horacekj/mgrthesis/thesis.tex

\documentclass[digital, oneside, table, nolot, nolof]{fithesis3}
%\documentclass[printed, twoside, table, nolot, nolof]{fithesis3}

%% The following section sets up the locales used in the thesis.
\usepackage[resetfonts]{cmap}
\usepackage[T1]{fontenc}
\usepackage[main=czech, english]{babel}

%% The following section sets up the metadata of the thesis.
\thesissetup{
    date          = \the\year/\the\month/\the\day,
    university    = mu,
    faculty       = fi,
    type          = mgr,
    author        = Jan Horáček,
    gender        = m,
    advisor       = {RNDr. Zdeněk Matěj, Ph.D.},
    title         = {Návrh a implementace nového protokolu sběrnice MTBbus},
    TeXtitle      = {Návrh a implementace nového protokolu sběrnice MTBbus},
    keywords      = {sběrnice, plc, mtb, mtbbus, rs485, embedded, stm32, qt, usb, cdc, protokol, avr, arm, dcc},
    TeXkeywords   = {sběrnice, plc, mtb, mtbbus, rs485, embedded, stm32, qt, usb, cdc, protokol, avr, arm, dcc},
    abstract      = {\input{abstrakt.tex}},
    thanks        = {\input{dik.tex}},
    bib           = bibliography.bib,
    titleEn       = {Design and implementation of a new MTBbus protocol},
    TeXtitleEn    = {Design and implementation of a new MTBbus protocol},
    keywordsEn    = {bus, mtb, rs485, embedded, stm32, C++, qt, protocol, avr, arm, kicad},
    TeXkeywordsEn = {bus, mtb, rs485, embedded, stm32, C++, qt, protocol, avr, arm, kicad},
    assignment    = {data/zadani_ofic.pdf},
}
\usepackage{makeidx}      %% The `makeidx` package contains
\makeindex                %% helper commands for index typesetting.
%% These additional packages are used within the document:
\usepackage{paralist} %% Compact list environments
\usepackage{amsmath}  %% Mathematics
\usepackage{amsthm}
\usepackage{amsfonts}
\usepackage{url}      %% Hyperlinks
\usepackage{listings} %% Source code highlighting
\usepackage{enumitem}
\usepackage{afterpage}
\usepackage{glossaries}
\usepackage{subfigure}
\makeglossaries
\lstset{
  basicstyle      = \ttfamily,%
  identifierstyle = \color{black},%
  keywordstyle    = \color{blue},%
  keywordstyle    = {[2]\color{cyan}},%
  keywordstyle    = {[3]\color{olive}},%
  stringstyle     = \color{teal},%
  commentstyle    = \itshape\color{magenta}}
\usepackage{floatrow} %% Putting captions above tables
\floatsetup[table]{capposition=top}
\Urlmuskip=0mu plus 1mu
\begin{document}

% Highlight overfulls
% \setlength{\overfullrule}{5pt} % TODO: remove

\setlength{\parindent}{0cm}
\setlength{\parskip}{3mm plus2pt minus2pt}
\setlist{leftmargin=8mm}
\renewenvironment{compactenum}
	{\begin{enumerate}[leftmargin=8mm,itemsep=0pt,parsep=1pt,topsep=1pt,partopsep=1pt]}
	{\end{enumerate}}
\renewenvironment{compactitem}
	{\begin{itemize}[leftmargin=8mm,itemsep=0pt,parsep=0pt,topsep=1pt,partopsep=1pt]}
	{\end{itemize}}

\input{zkratky}

\chapter{Úvod} \label{chap:uvod}
\input{uvod}

\chapter{Současné nasazení sběrnice MTBbus} \label{chap:nasazeni}
\input{soucasne-nasazeni}

\chapter{Existující řešení} \label{chap:existujici-reseni}
\input{existujici-reseni}

\chapter{Návrh MTB v4} \label{chap:mtb-v4-design}
\input{mtbv4-design}

\chapter{Implementace MTB v4} \label{chap:mtb-v4-impl}
\input{mtb-usb-v4}
\input{mtb-uni-v4}
\input{mtb-2-avr}
\input{irdet}
\input{mtb-daemon}
\input{mtb-net-lib}

\chapter{Závěr} \label{chap:zaver}
\input{zaver}

\printbibliography[heading=bibintoc]

\appendix
\chapter{Přílohy} \label{chap:appendix}
\input{appendix}

\end{document}
