horacekj/mgrthesis/zkratky.tex

\newglossaryentry{plc} {
	name=PLC,
	description={Programmable Logic Controller, robustní zařízení průmyslové
	automatizace}
}

\newglossaryentry{mtb} {
	name=MTB,
	description={Hardwarový systém pro řízení modelových kolejišť složený ze
	sběrnice MTBbus, MTB modulů, MTB-USB desky a~počítačových knihoven}
}

\newglossaryentry{mtbbus} {
	name=MTBbus,
	description={Model Train Bus\footnote{Expanze zkratky do jejího plného
	významu nedává smysl, i tak budeme používat označení MTBbus, protože tak je
	zkratka zaužívaná.}, sběrnice určená pro řízení modelových kolejišť}
}

\newglossaryentry{dcc} {
	name=DCC,
	description={Digital Command Control, mezinárodně užívaný standardizovaný
	systém pro digitální řízení modelové železnice}
}

\newglossaryentry{kmz}{
	name={KMŽ Brno~I},
	description={Klub modelářů železnic Brno~I}
}

\newglossaryentry{nmra}{
	name={NMRA},
	description={National Model Railroad Association}
}

\newglossaryentry{mtbusb}{
	name={MTB-USB},
	description={Master modul sběrnice MTBbus, implementuje rozhraní mezi MTBbus
	a počítačem (USB)}
}

\newglossaryentry{mtbuni}{
	name={MTB-UNI},
	description={Nejrozšířenější slave modul sběrnice MTBbus, má 16~digitálních
	vstupů a~16~digitálních výstupů}
}

\newglossaryentry{ttl}{
	name={TTL},
	description={Transistor-transistor-logic, v~kontextu této práce standard
		definující jaká napěťová úroveň odpovídá jaké logické úrovni}
}

\newglossaryentry{usb}{
	name={USB},
	description={Universal Serial Bus, v současnosti nejpoužívanější sběrnice
	pro připojení periferií k počítači}
}

\newglossaryentry{cdc}{
	name={CDC},
	description={USB Comunications Device Class, třída USB protokolu implementující
		tunelování sériové linky skrze USB}
}

\newglossaryentry{dps}{
	name={DPS},
	description={Deska plošnýcn spojů}
}

\newglossaryentry{scom}{
	name={S-COM},
	description={Jednoduchý jednosměrný komunikační protokol, který umožňuje
	přenášet návěsti návěstidel \cite{scom-specs}}
}

\newglossaryentry{bidib}{
	name={BiDiB},
	description={BiDirectional Bus, viz \url{http://bidib.org/}}
}

\newglossaryentry{hid}{
	name={HID},
	description={Human Interface Device, třída USB protokolu sloužící
	k~připojení zařízení interagujících s~uživatelem – myší, klávesnic apod}
}

\newglossaryentry{dil}{
	name={DIL},
	description={Dual in-line package, způsob provedení pouzdra integrovaných obvodů
		s~dvěma řadami pinů pro osazovaní do děr (tzv. \textit{THT} osazování)}
}

\newglossaryentry{smd}{
	name={SMD},
	description={Surface mount device, elektronická součástka určená pro osazení
		přímo na povrch plošného spoje}
}

\newglossaryentry{led}{
	name={LED},
	description={Light emitting diode, součástka vydávající světlo určité barvy}
}

\newglossaryentry{tcp}{
	name={TCP},
	description={Transmission Control Protocol, používaný protokol transportní
		vrstvy počítačových sítí garantující spolehlivé doručování dat}
}

\newglossaryentry{api}{
	name={API},
	description={Application Interface, rozhraní aplikace}
}

\newglossaryentry{ir}{
	name={IR},
	description={Infra-red}
}

\printglossary[title=Seznam použitých zkratek]
