horacekj/mgrthesis/pres/data/mtb-topology-en.pdf

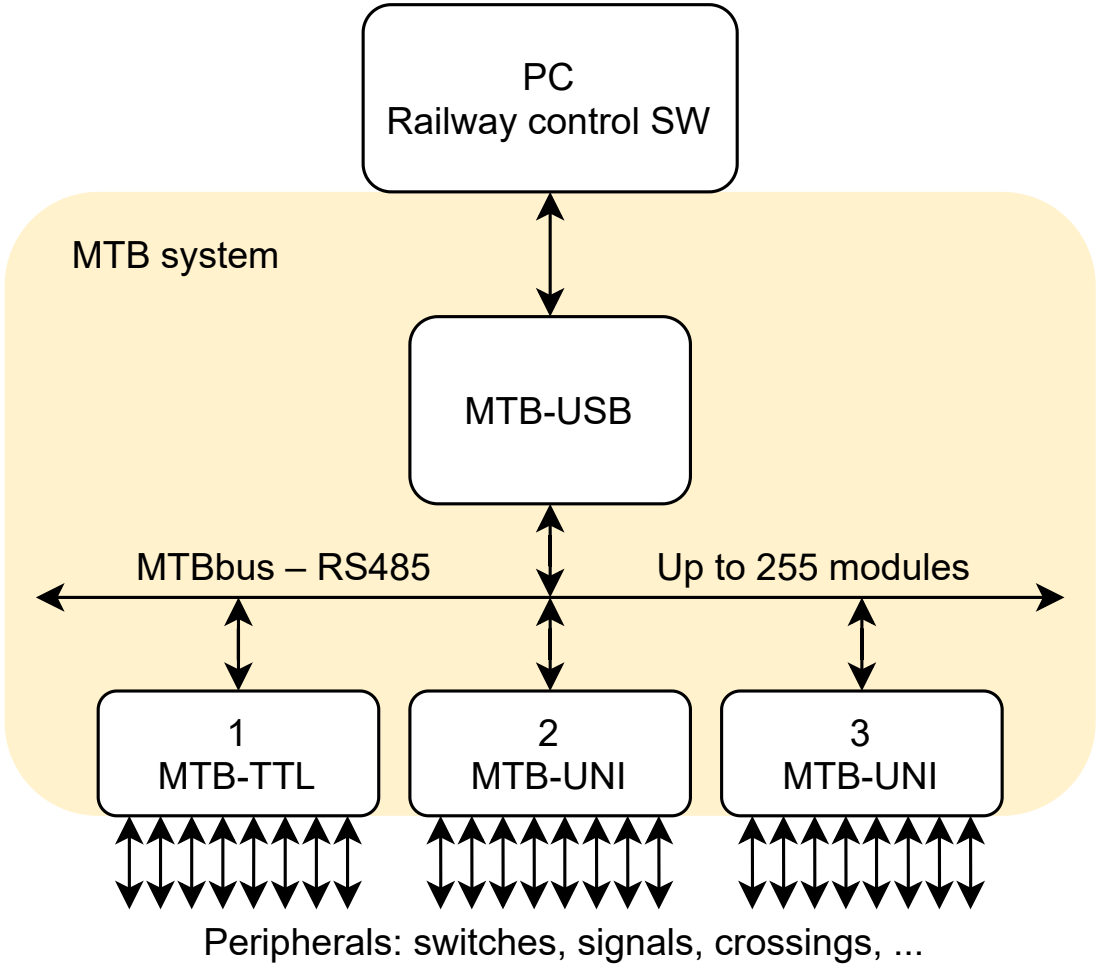
[picture p11: page 1]
MTB-USB; 2 MTB-UNI; 3 MTB-UNI; 1 MTB-TTL; MTBbus – RS485; MTB system

Railway control SW

Up to 255 modules

Peripherals: switches, signals, crossings, ...
