horacekj/mgrthesis/pres/data/new-topology-en.pdf

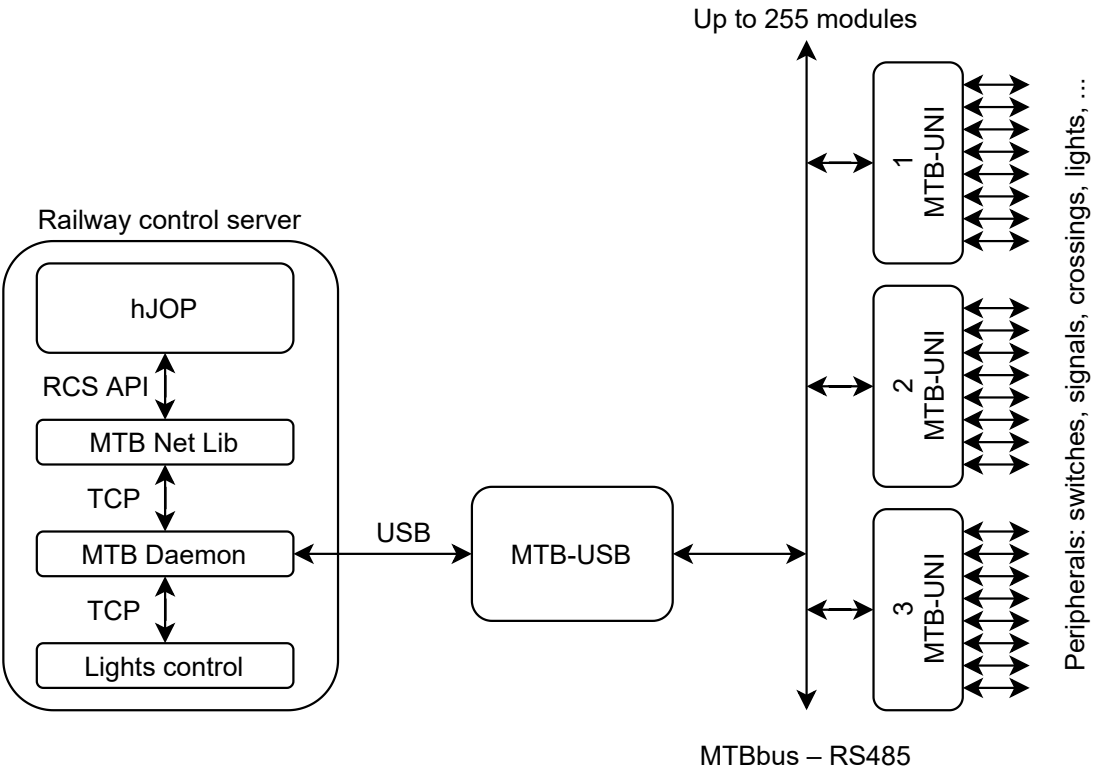
[picture p12: page 1]
MTB-USB; MTBbus – RS485; USB; hJOP; MTB-UNI

Up to 255 modules

Peripherals: switches, signals, crossings, lights, ...

Railway control server

RCS API
MTB Net Lib
TCP
MTB Daemon
Lights control
