horacekj/mgrthesis/data/mtb-topology.pdf

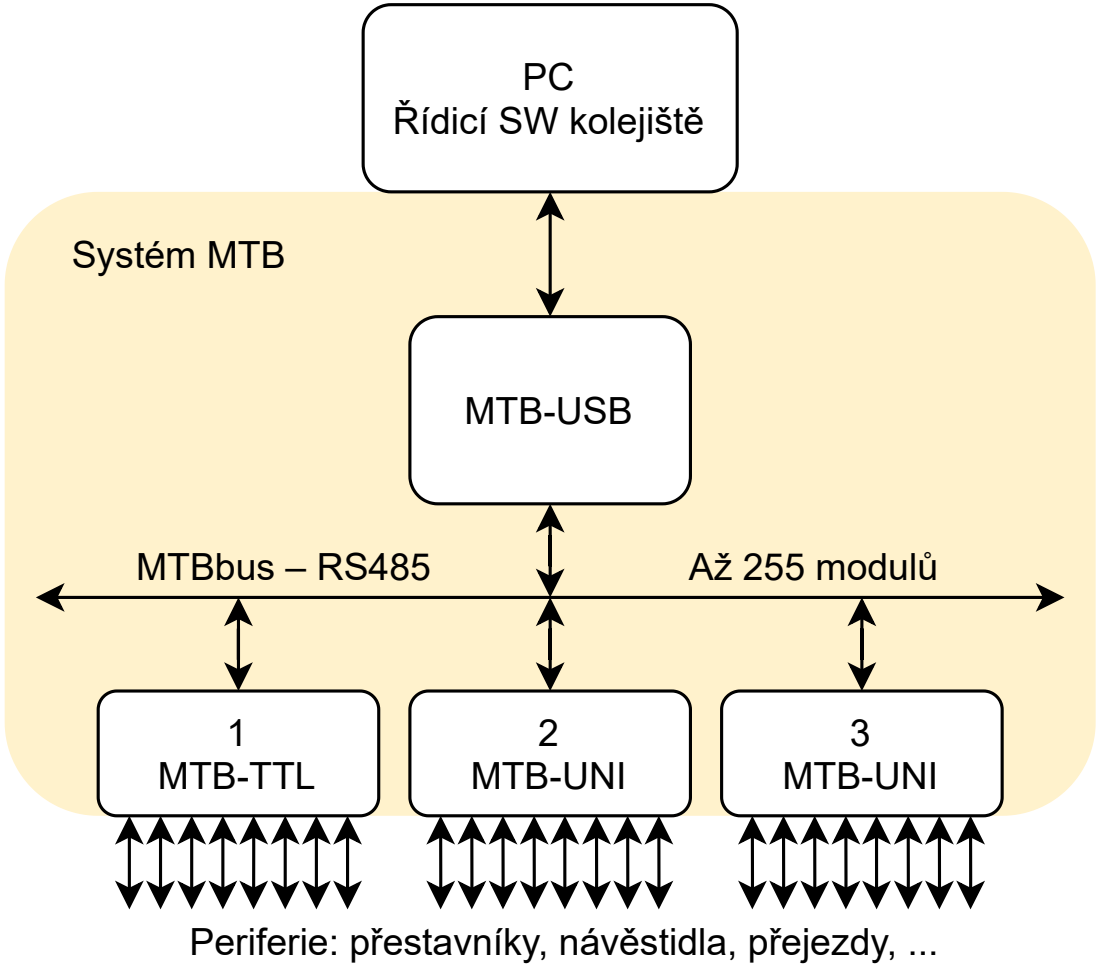
[picture p13: page 1]
MTB-USB; 2 MTB-UNI; 3 MTB-UNI; 1 MTB-TTL; MTBbus – RS485; Až 255 modulů; Systém MTB

Řídicí SW kolejiště

Periferie: přestavníky, návěstidla, přejezdy, ...
