horacekj/mgrthesis/data/new-topology.pdf

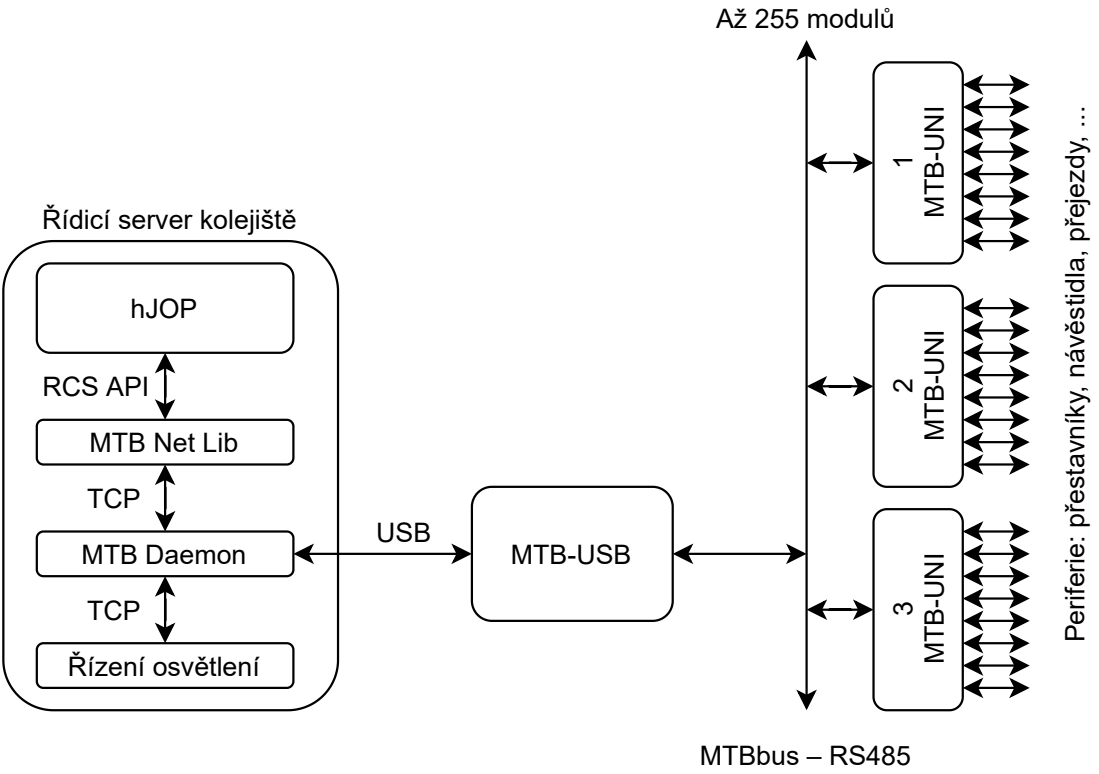
[picture p14: page 1]
MTB-USB; MTBbus – RS485; Až 255 modulů; USB; hJOP; MTB-UNI

Periferie: přestavníky, návěstidla, přejezdy, ...

Řídicí server kolejiště

RCS API
MTB Net Lib
TCP
MTB Daemon
Řízení osvětlení
