horacekj/mgrthesis/data/railroad-diagram.pdf

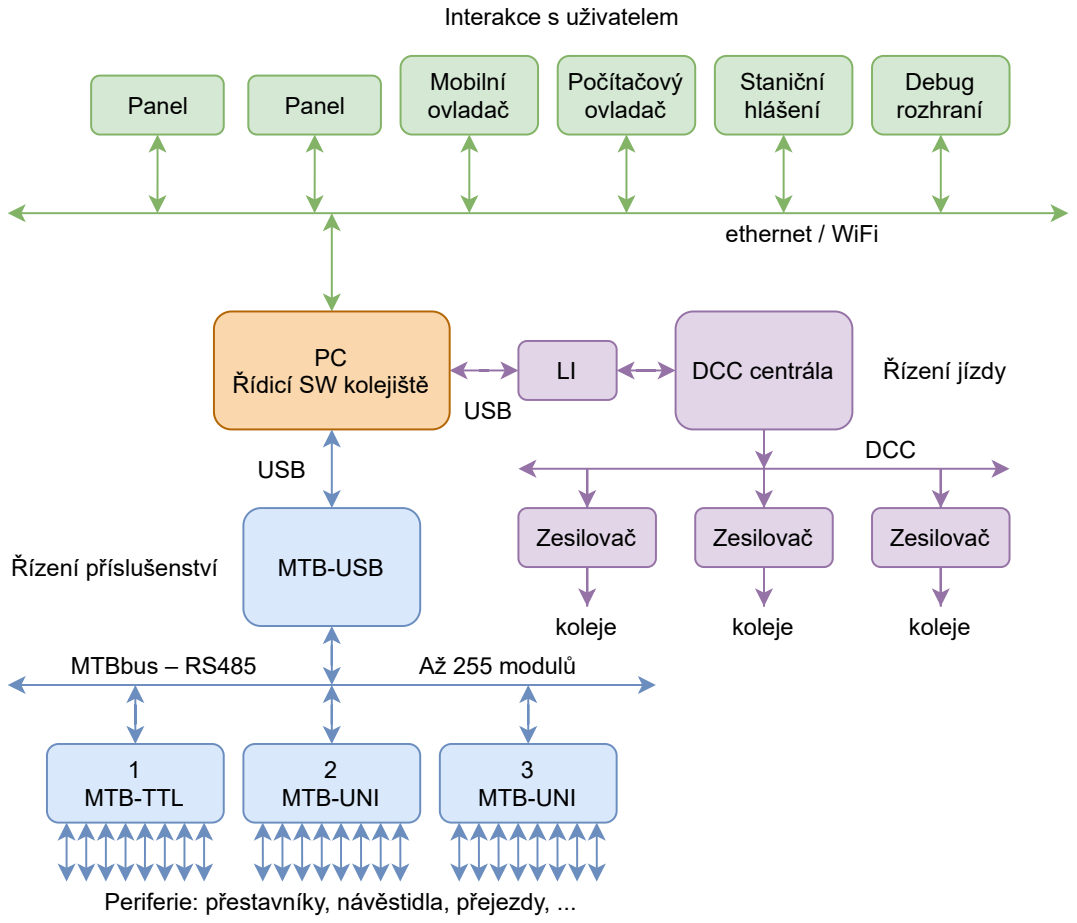
[picture p15: page 1]
MTB-USB; 2 MTB-UNI; 3 MTB-UNI; 1 MTB-TTL; MTBbus – RS485; Až 255 modulů; DCC centrála; Zesilovač; DCC; Panel; Mobilní ovladač; Počítačový ovladač; Staniční hlášení; Debug rozhraní; ethernet / WiFi; Řízení jízdy; Interakce s uživatelem; koleje; USB; Řízení příslušenství

Řídicí SW kolejiště

Periferie: přestavníky, návěstidla, přejezdy, ...
