horacekj/mgrthesis/data/irdet-ele.pdf

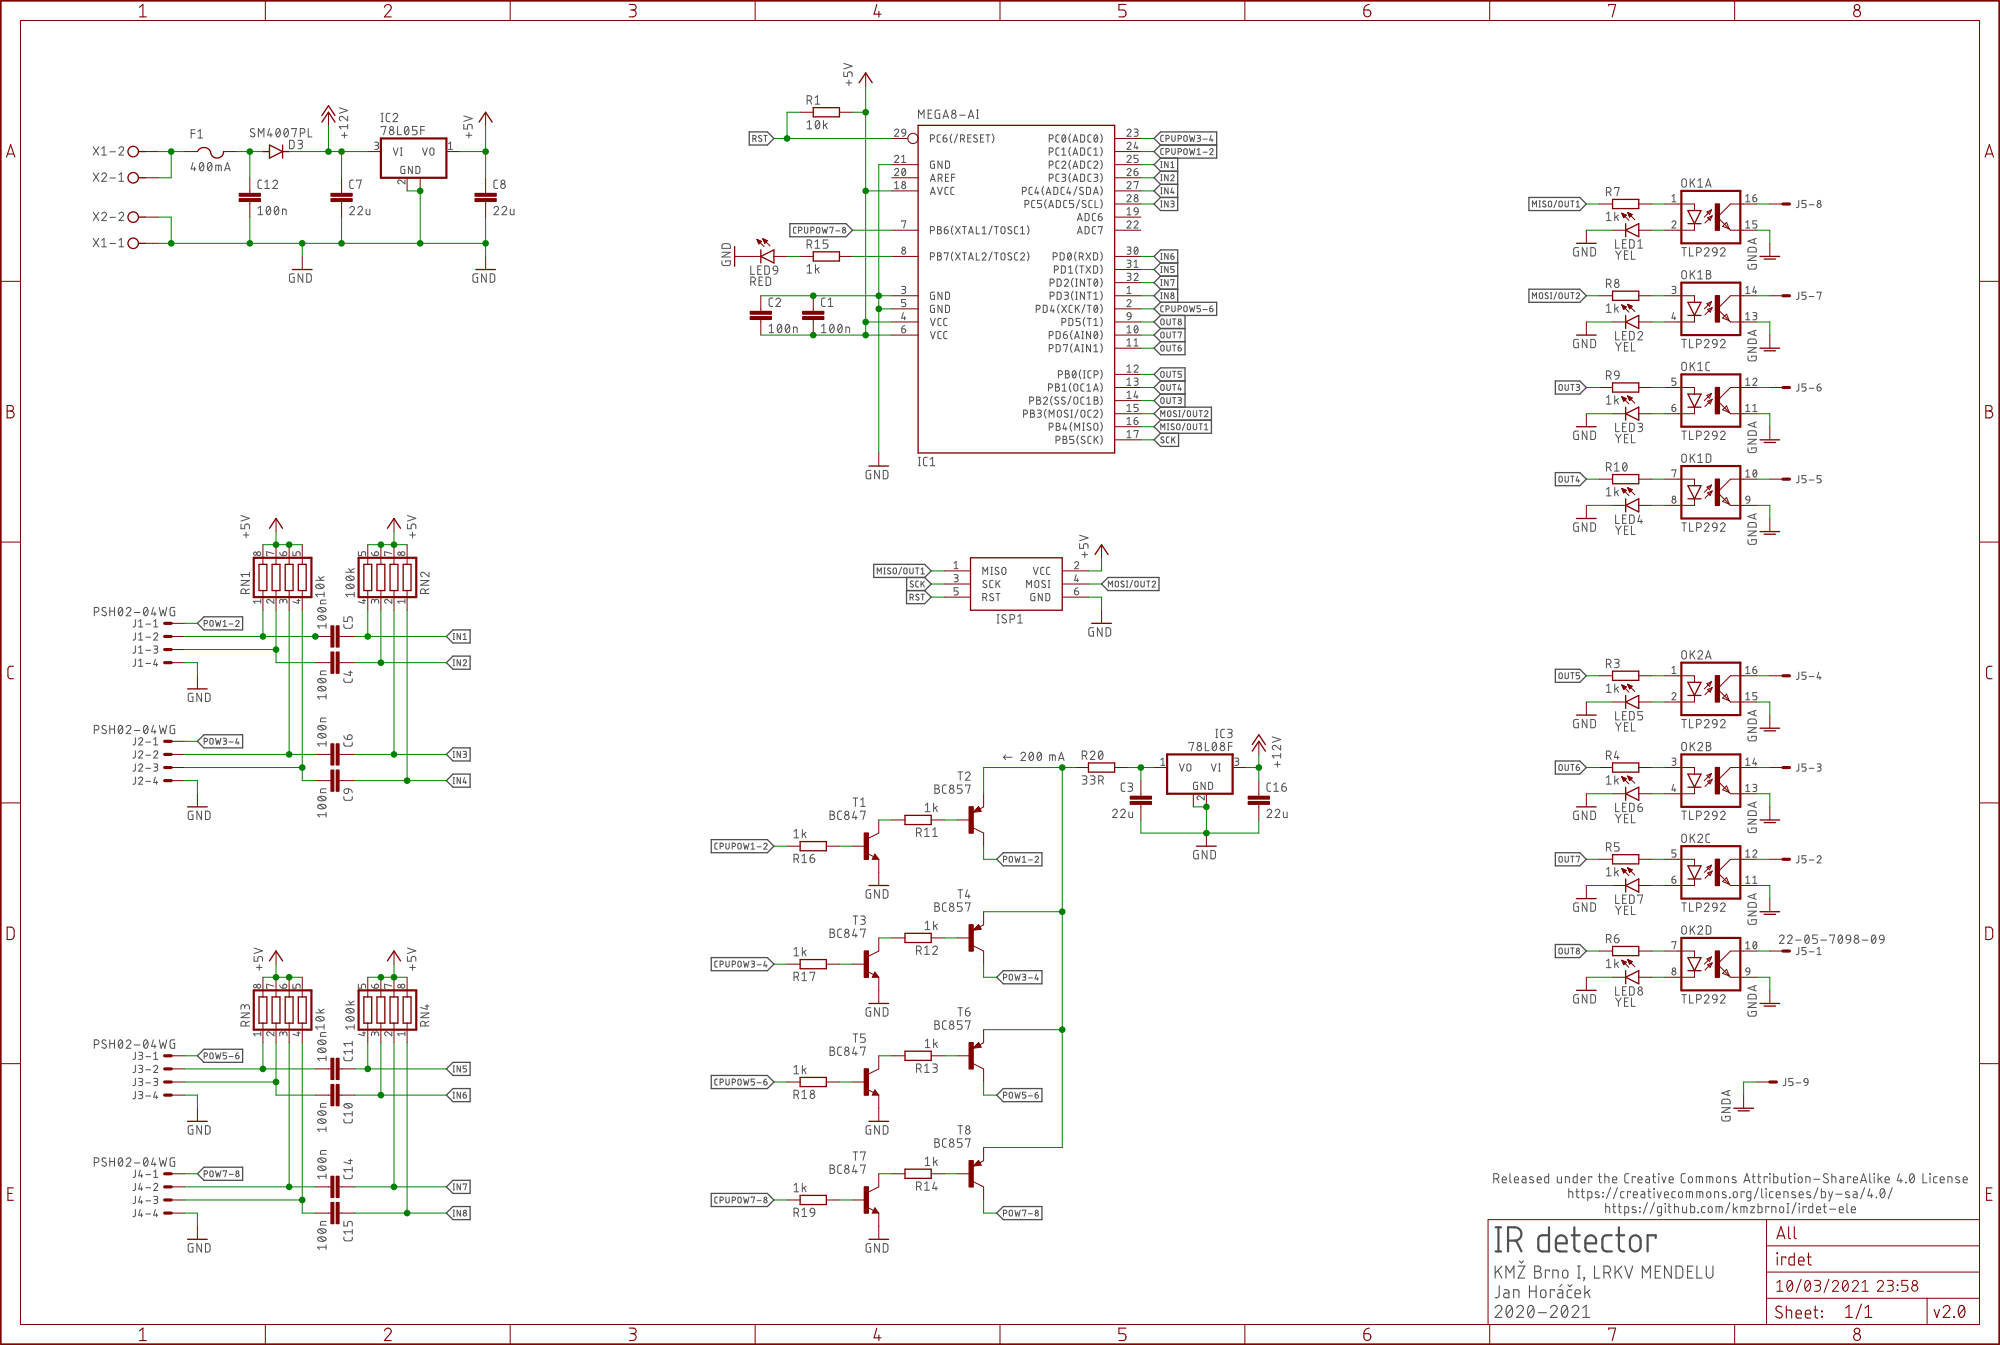
[picture p16: page 1]
