horacekj/mgrthesis/data/mtb-2-avr-ele.pdf

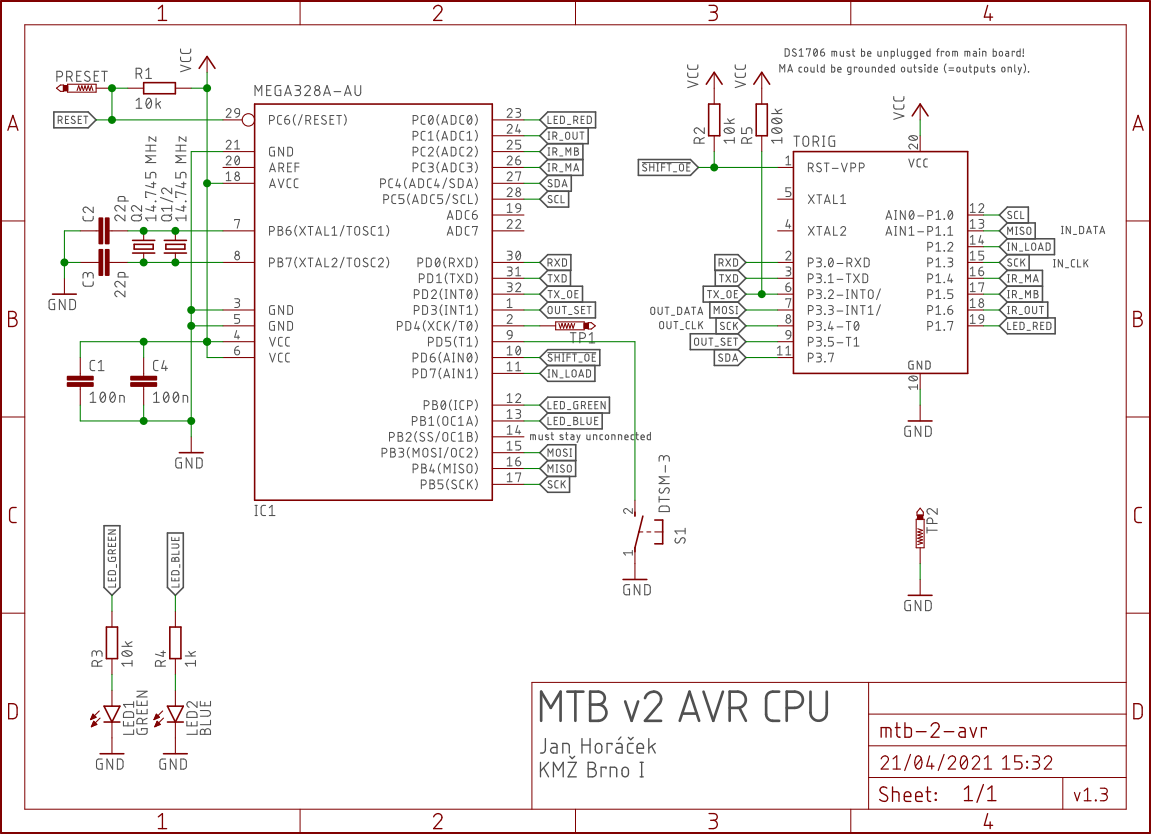
[picture p17: page 1]
