horacekj/mgrthesis/data/mtb-uni-4-ele.pdf

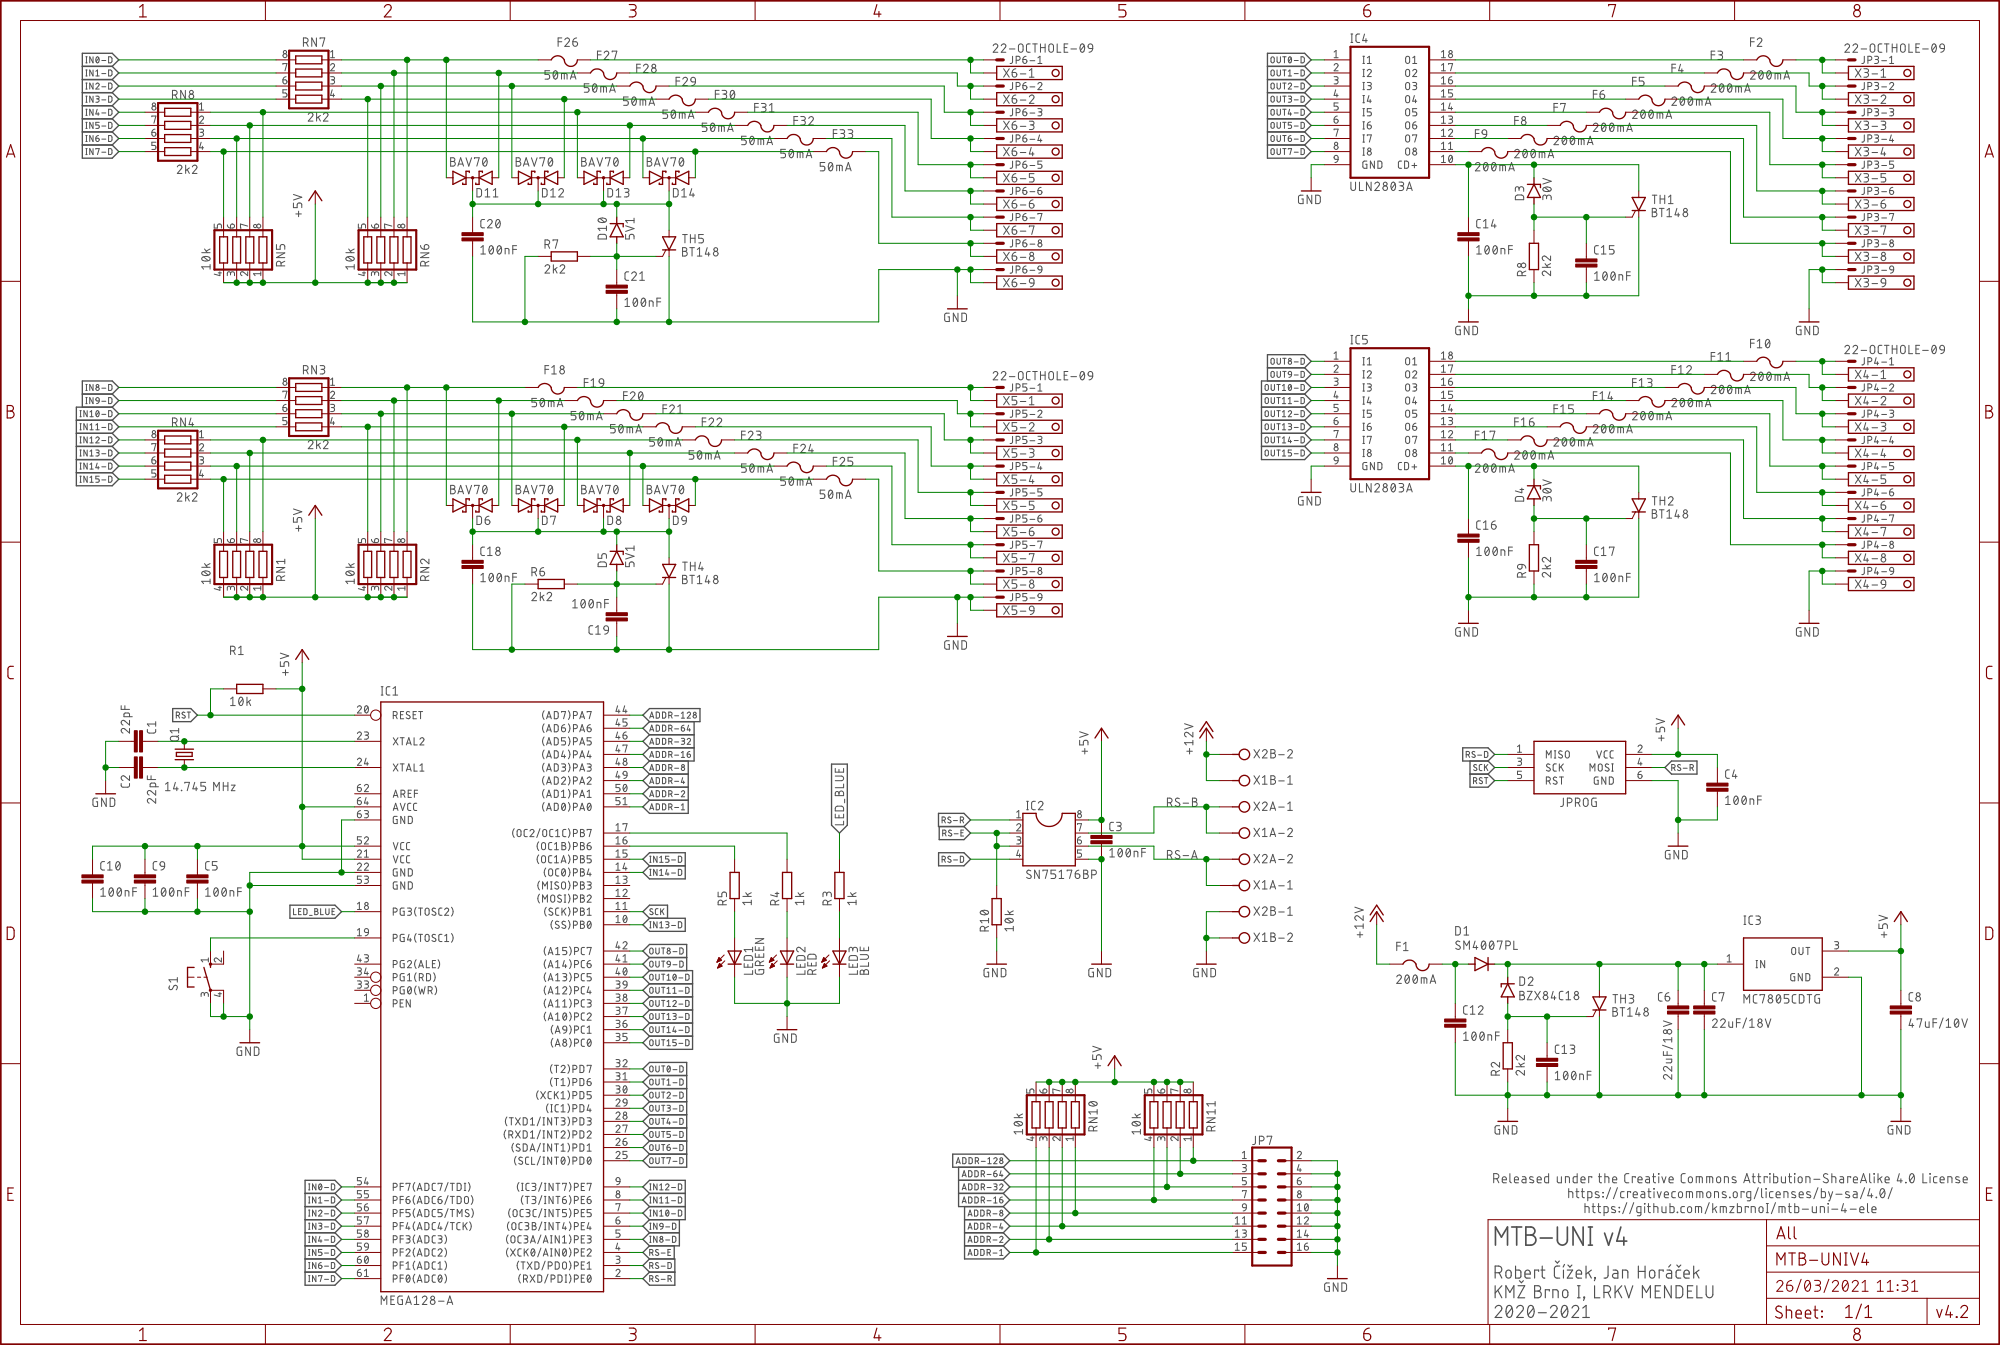
[picture p18: page 1]
