horacekj/mgrthesis/data/mtb-usb-4-ele.pdf

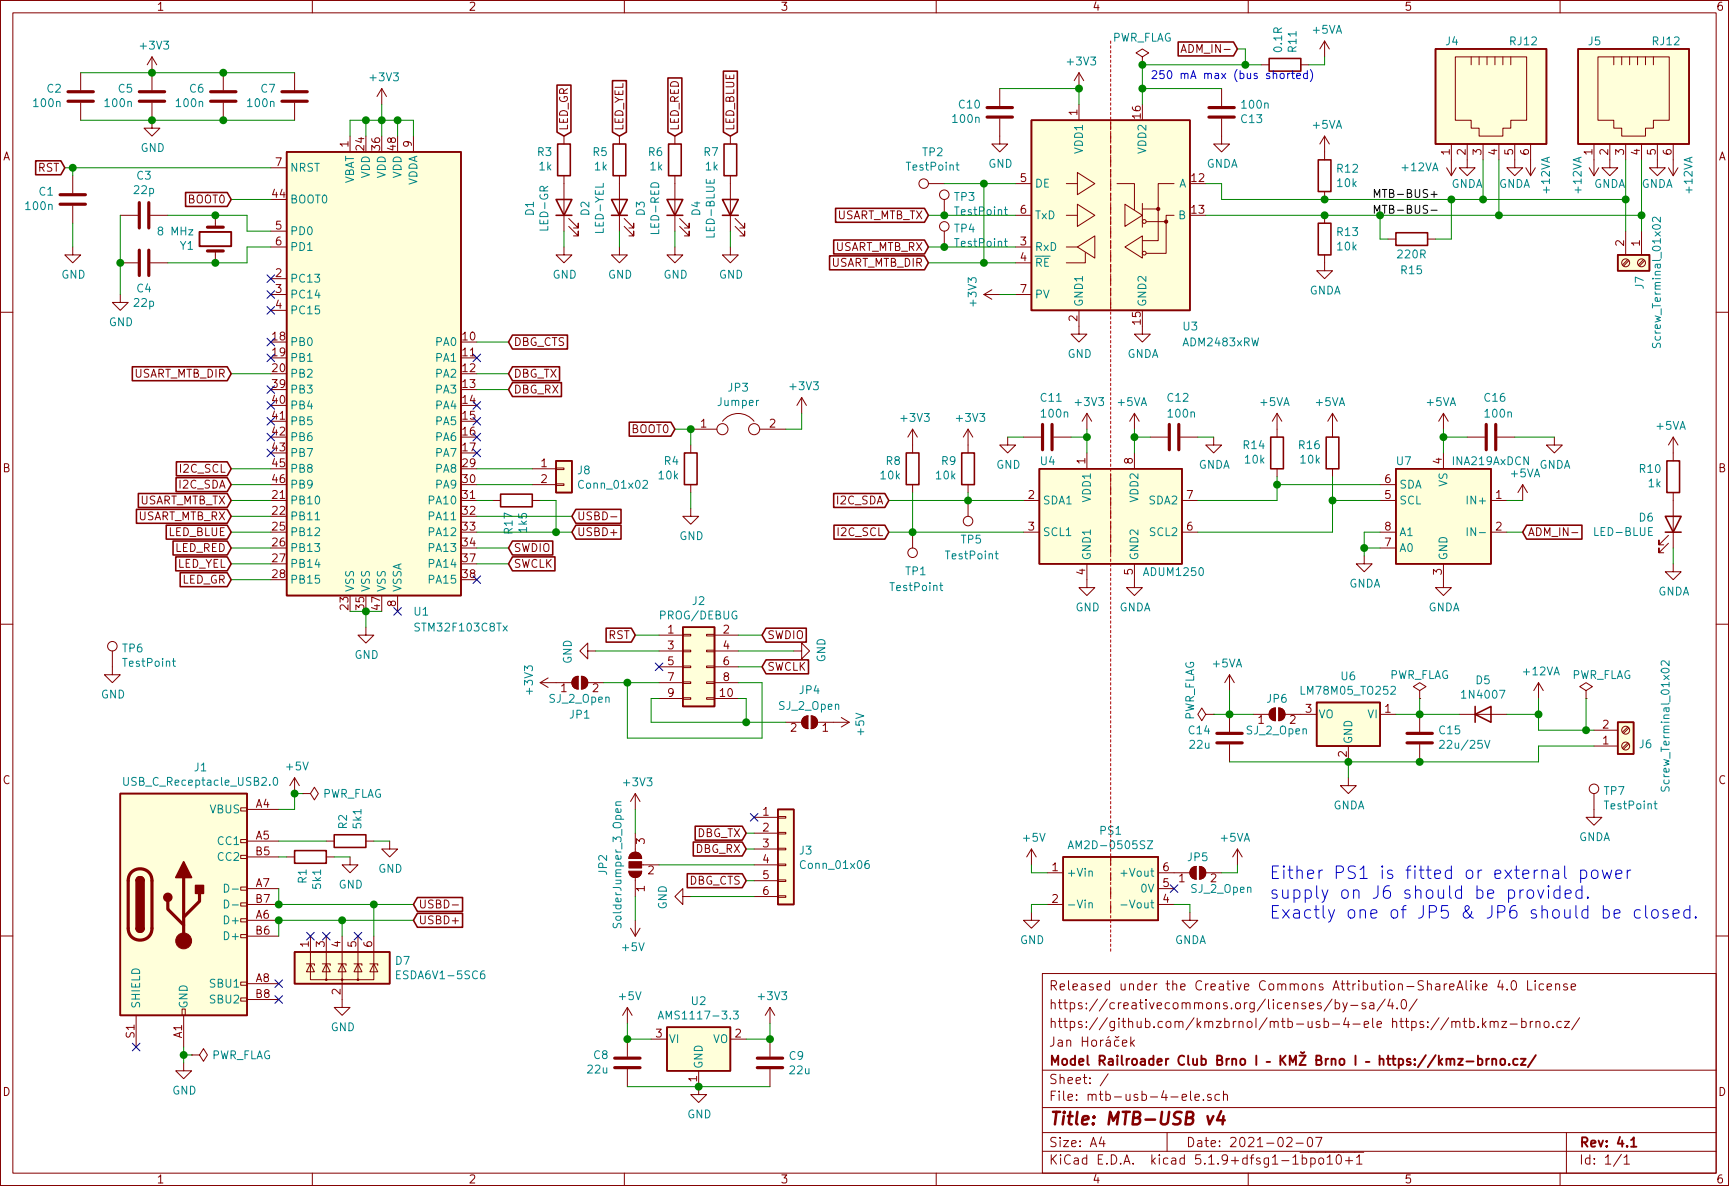
[picture p19: page 1]
