horacekj/mgrthesis/data/loconet.pdf

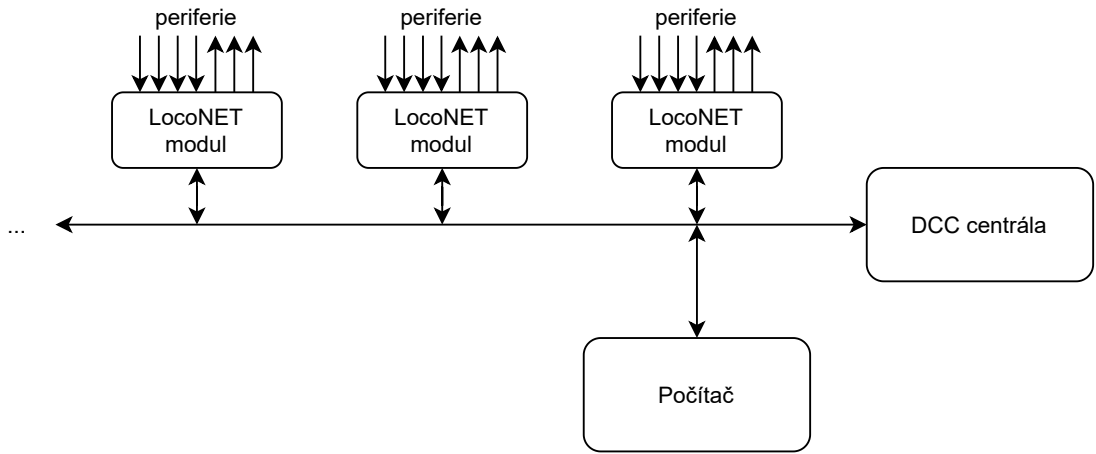
[picture p20: page 1]
DCC centrála; LocoNET modul; periferie; Počítač
