horacekj/mgrthesis/data/rs.pdf

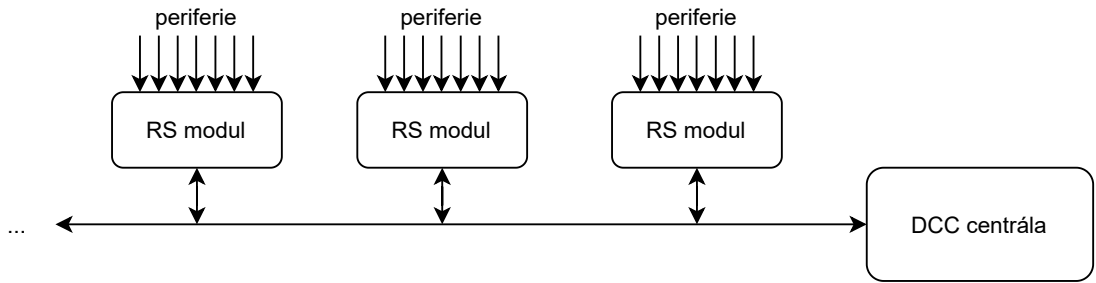
[picture p21: page 1]
DCC centrála; RS modul; periferie
