horacekj/mgrthesis/data/schema_dcc_en.pdf

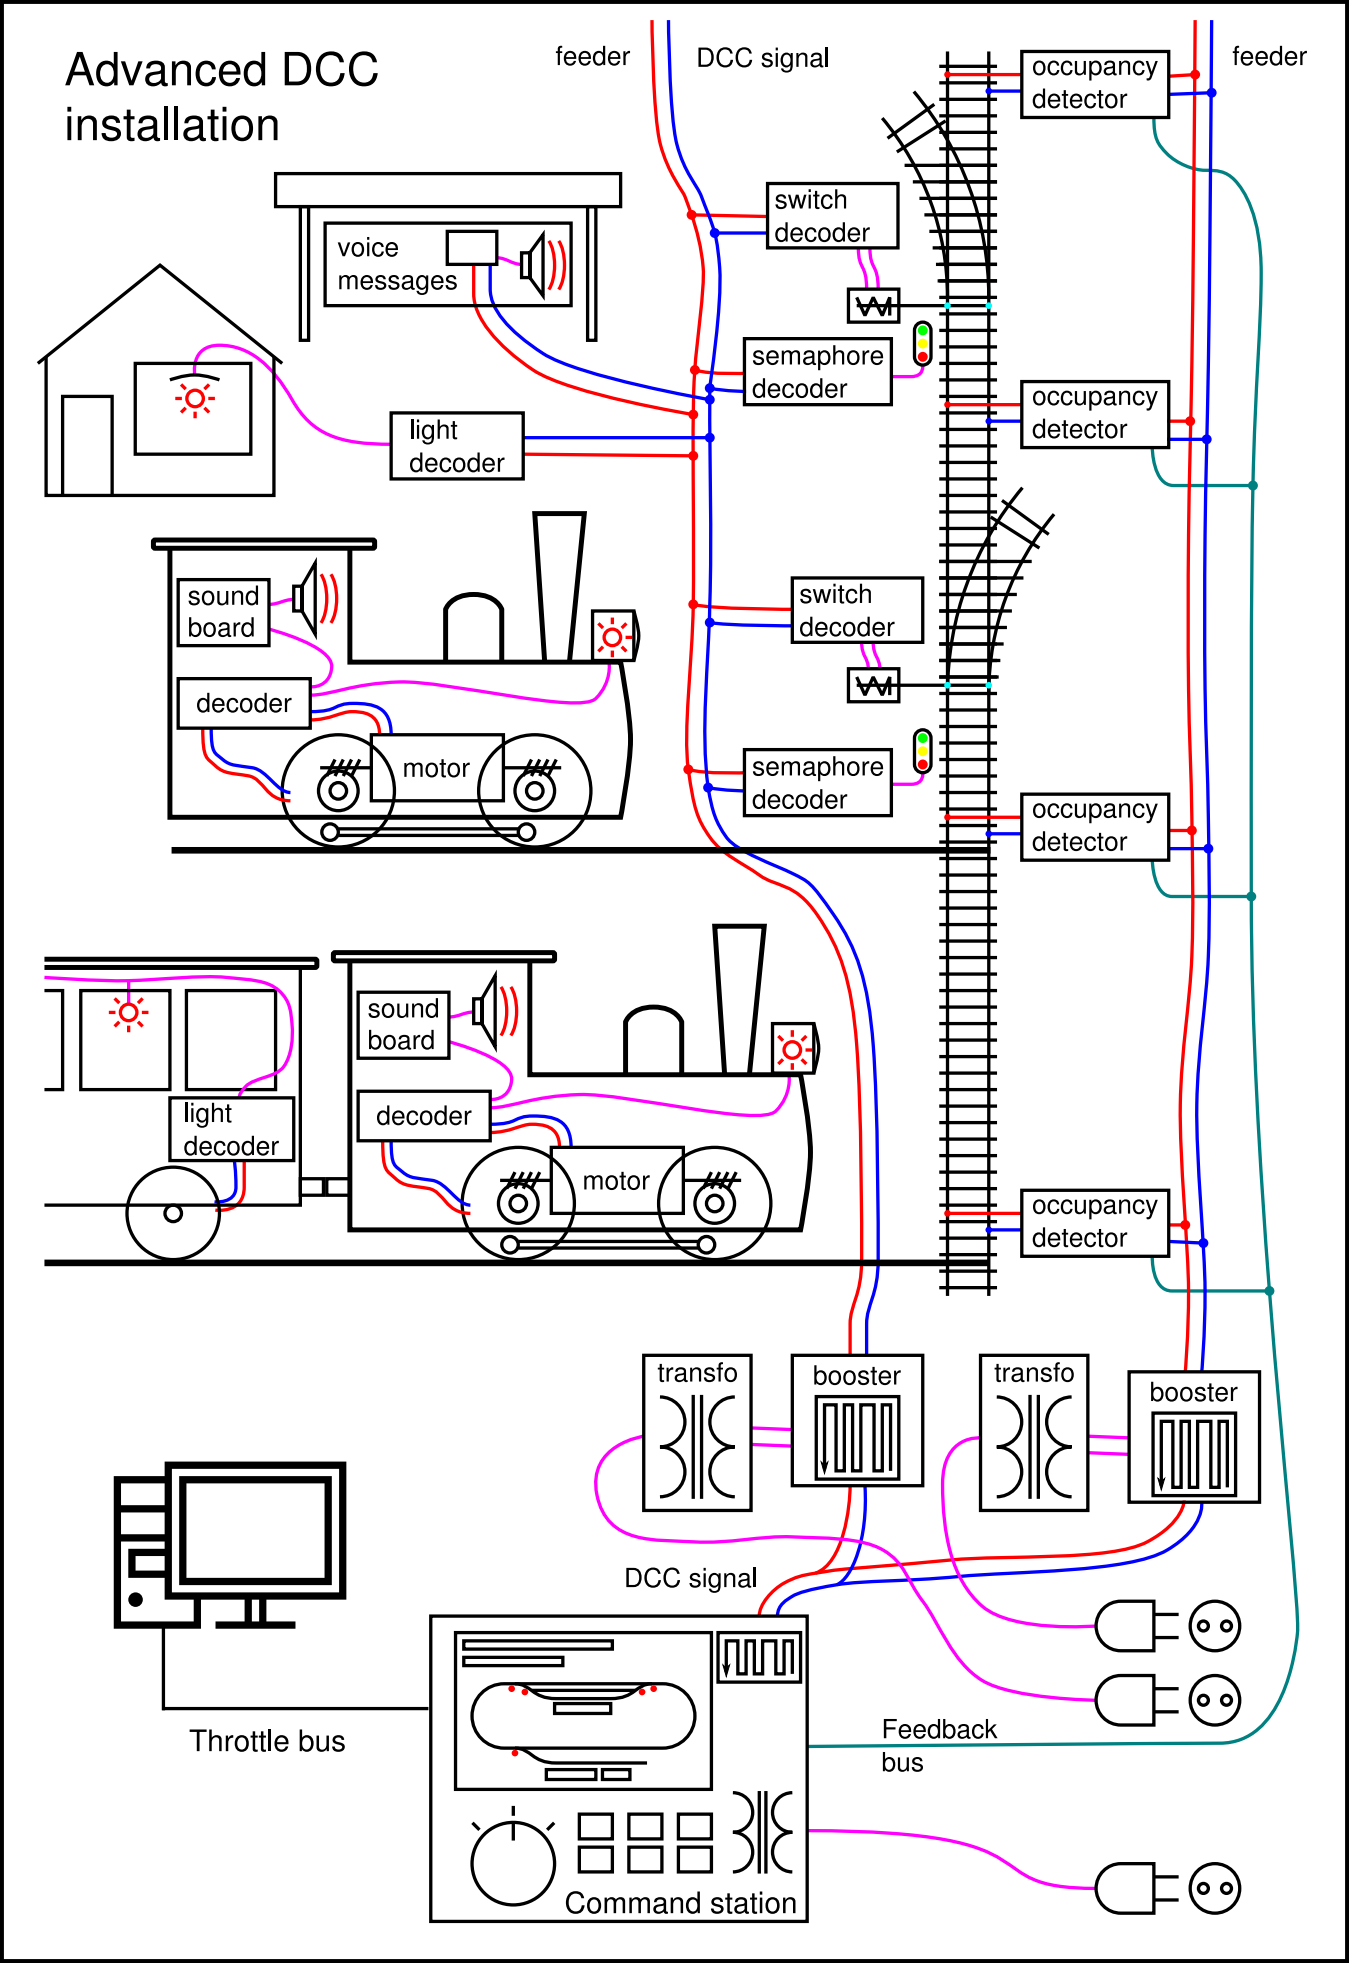
[picture p22: page 1]
