horacekj/mgrthesis/data/uni-input/uni-input.pdf

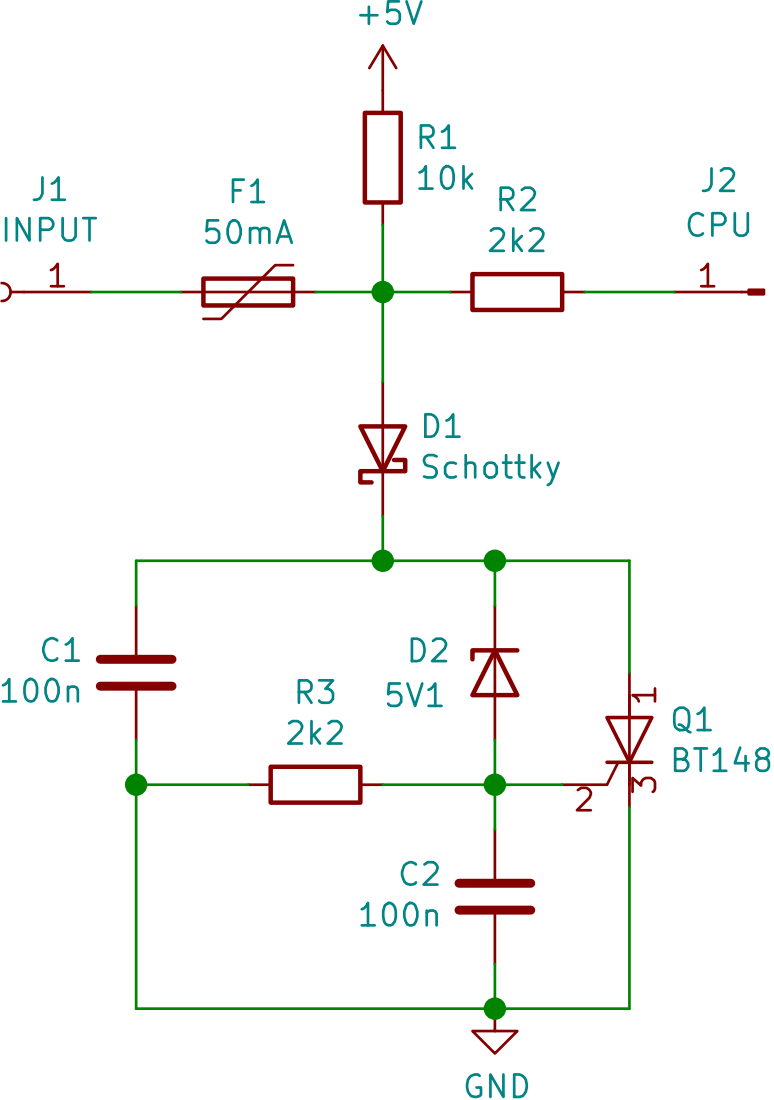
[picture p23: page 1]
