horacekj/mgrthesis/data/cap-bind/capacitive-bind-example.pdf

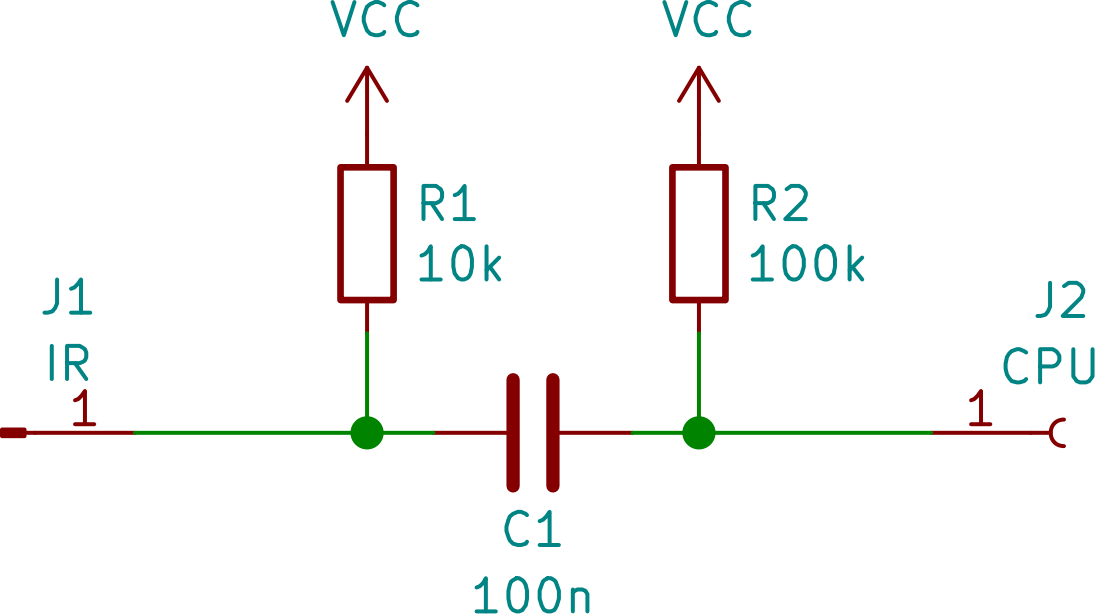
[picture p24: page 1]
