horacekj/mgrthesis/data/uni-input/uni-input.sch

## KiCad design data/uni-input/uni-input.sch (2021-04-30)

Schematic: uni-input.sch

Parts:
C1, C2: 100n
D1: Schottky
D2: 5V1
F1: 50mA
J1: INPUT
J2: CPU
Q1: BT148; TO-92_Inline
R1: 10k
R2, R3: 2k2
