horacekj/mgrthesis/(commit log)

2021-04-25 Add whole railroad control schematics.
2021-04-25 Finish current deployment.
2021-04-28 Several enhancements to section "Current deployment".
    [capacitive-bind-example.sch]
2021-04-28 Add more tweaks to "current deployment".
2021-04-29 MTB-USB: add protocol, schematics & pcb description.
2021-04-30 Split thesis into more files.
    [uni-input.sch]
2021-05-06 Add rest of schematics to appendix.
